ahmetcan-akuz/Optimus-Primary-Winding/Reports/Final Report/pictures/transformer_pri.JPG

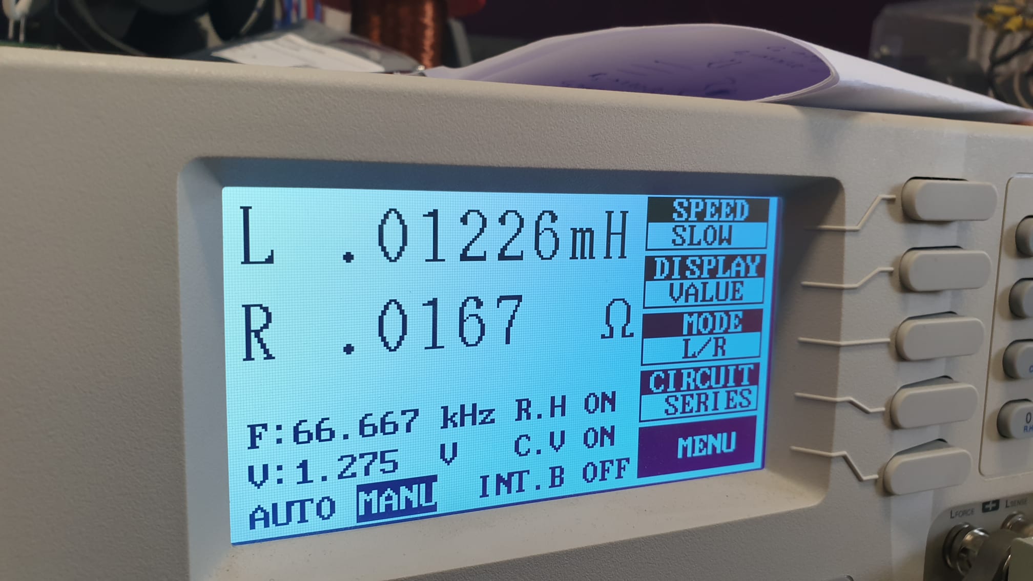
Reports/Final Report/pictures/transformer_pri.JPG
