ahmetcan-akuz/Optimus-Primary-Winding/Reports/Final Report/pictures/transformer_leak_init.jpg

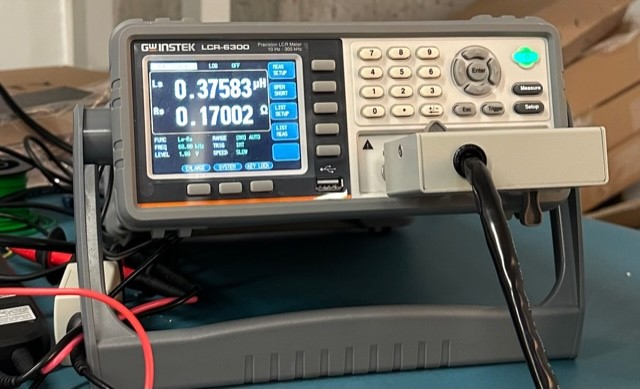
Reports/Final Report/pictures/transformer_leak_init.jpg
