ahmetcan-akuz/Optimus-Primary-Winding/README.md

# Optimus-Primary-Winding
This is the EE 464 Hardware Project Repository of Optimus Primary Winding
