ahmetcan-akuz/Optimus-Primary-Winding/PCB/Gerber2/Transcode Report.txt

   ---- Transcoding 'C:\Users\ahmetcan.akuz\Documents\GitHub\Optimus-Primary-Winding\PCB\Gerber2\flyback-B_Mask.gbr' ----   Sun Jun 11 21:21:48 2023

D12   --> D100
D13   --> D101
D14   --> D102
D15   --> D103
D16   --> D104
D17   --> D105
-----------------------------------------------------------------

   ---- Transcoding 'C:\Users\ahmetcan.akuz\Documents\GitHub\Optimus-Primary-Winding\PCB\Gerber2\flyback-Edge_Cuts.gbr' ----   Sun Jun 11 21:21:48 2023

D10   --> D106
-----------------------------------------------------------------

   ---- Transcoding 'C:\Users\ahmetcan.akuz\Documents\GitHub\Optimus-Primary-Winding\PCB\Gerber2\flyback-F_Cu.gbr' ----   Sun Jun 11 21:21:48 2023

D12   --> D107
D13   --> D108
D14   --> D109
D15   --> D110
D16   --> D111
D17   --> D112
D18   --> D113
-----------------------------------------------------------------

   ---- Transcoding 'C:\Users\ahmetcan.akuz\Documents\GitHub\Optimus-Primary-Winding\PCB\Gerber2\flyback-F_Mask.gbr' ----   Sun Jun 11 21:21:48 2023

D12   --> D114
D13   --> D115
D14   --> D116
D16   --> D117
D17   --> D118
D18   --> D119
D19   --> D120
D20   --> D121
D21   --> D122
D22   --> D123
D23   --> D124
D24   --> D125
D25   --> D126
D26   --> D127
D27   --> D128
D28   --> D129
D29   --> D130
D30   --> D131
D31   --> D132
D32   --> D133
D33   --> D134
D34   --> D135
D35   --> D136
D36   --> D137
-----------------------------------------------------------------

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
D31   --> D127
D32   --> D128
D33   --> D129
D34   --> D130
D35   --> D131
-----------------------------------------------------------------

   ---- Transcoding 'C:\Users\ahmetcan.akuz\Documents\GitHub\Optimus-Primary-Winding\PCB\Gerber2\flyback-F_Paste.gbr' ----   Sun Jun 11 22:03:01 2023

D10   --> D132
D11   --> D133
D12   --> D134
D13   --> D135
D14   --> D136
D15   --> D137
D16   --> D138
D17   --> D139
D19   --> D140
D20   --> D141
D21   --> D142
D22   --> D143
D23   --> D144
D24   --> D145
D25   --> D146
D26   --> D147
D27   --> D148
D28   --> D149
D29   --> D150
-----------------------------------------------------------------
