ahmetcan-akuz/Optimus-Primary-Winding/Presentation_Baris.pptx

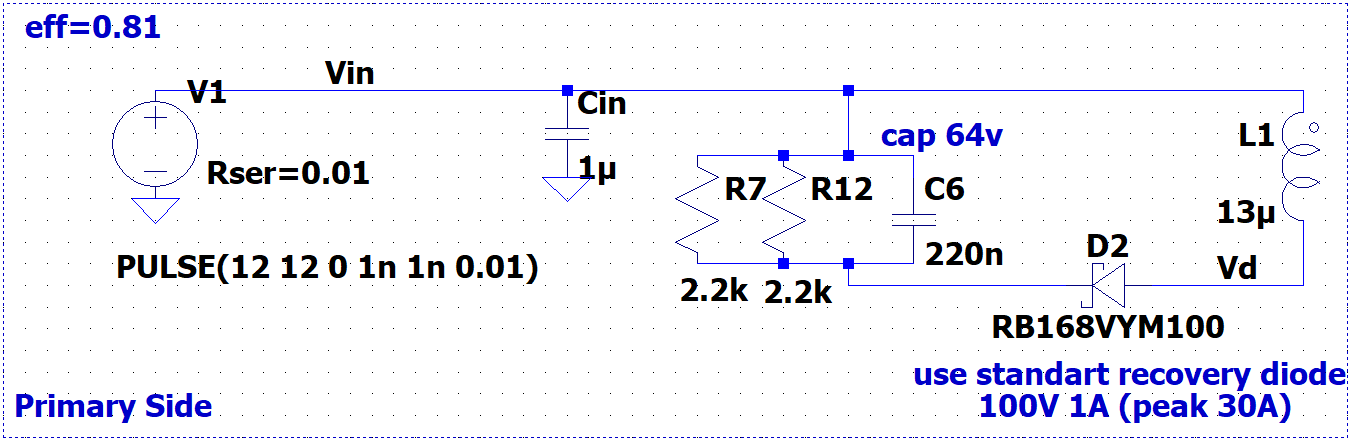
[picture p30: figure]

! 1W resistors will be used for snubbers

DIODE STAND. Single 1A 100V THT DO41

## Slide 2

Snubber Voltage and Primary Winding Current (12V input – Maximum Load)

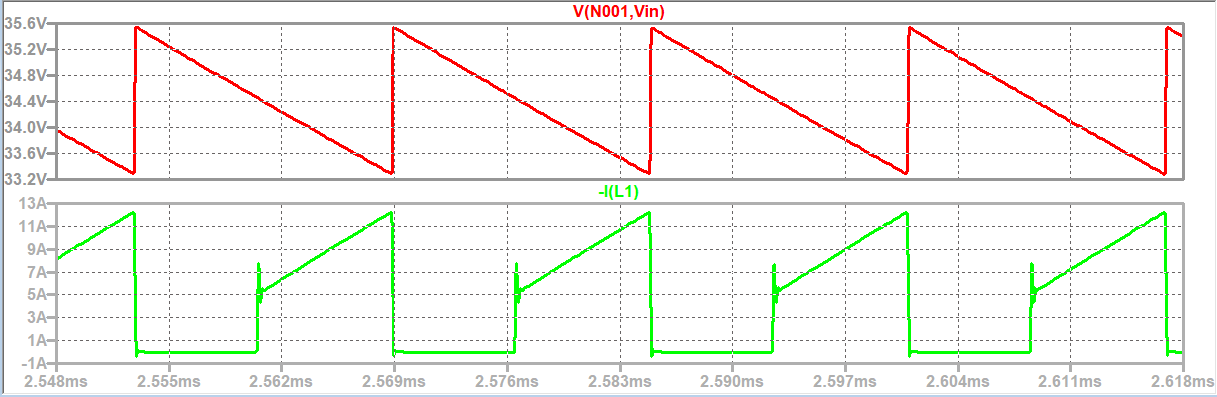
[picture p31: figure]

Snubber ripple is %10Vin and Vsnub=35V

## Slide 3

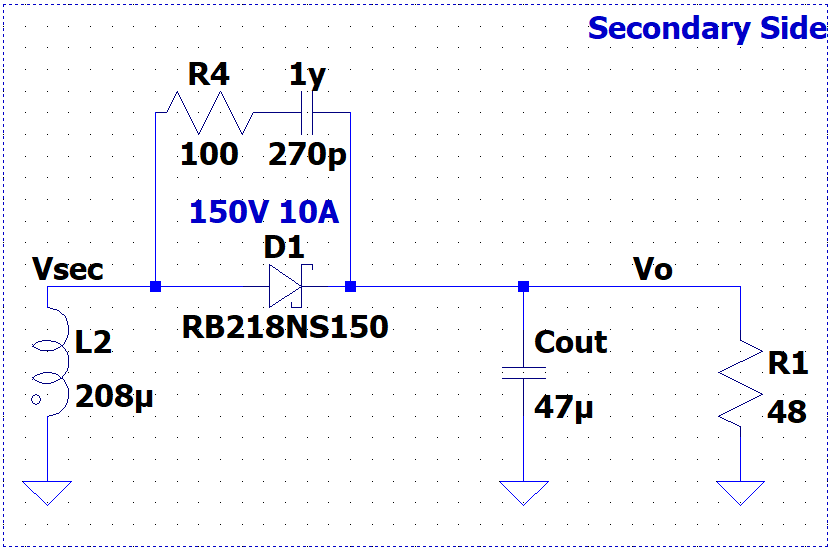
[picture p32: figure]

DIODE SCHOTTKY 10A 150V TO220AC THT

## Slide 4

Output Voltage,Secondary Diode Voltage and Winding Current (12V input – Maximum Load)

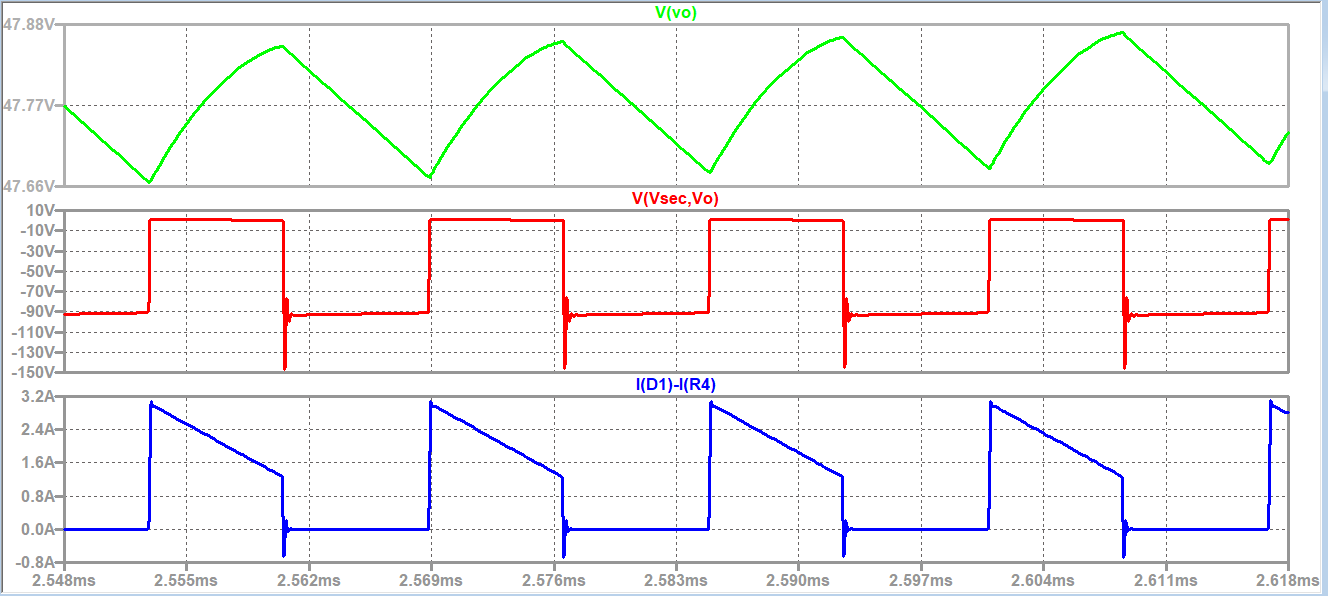
[picture p33: figure]

## Slide 5

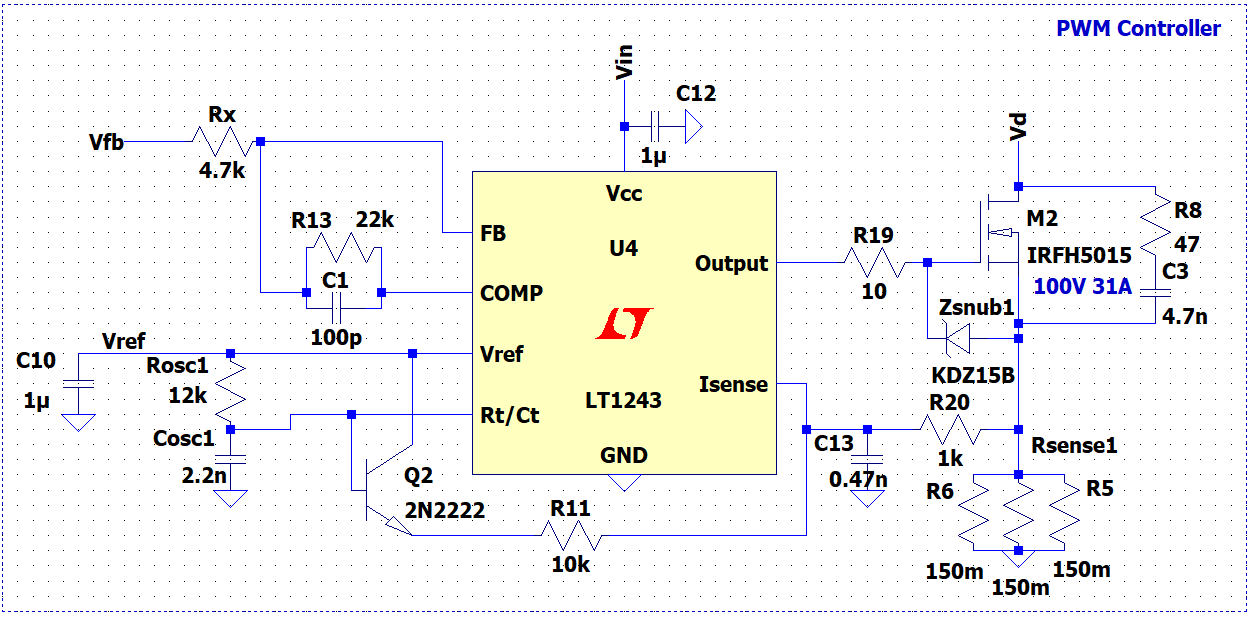
[picture p34: figure]

MOSFET DIS.31A 100V N-CH TO252(DPAK) HEXFET SMT

! 4W sense resistors will be used

## Slide 6

MOSFET Voltage and Current(12V input – Maximum Load)

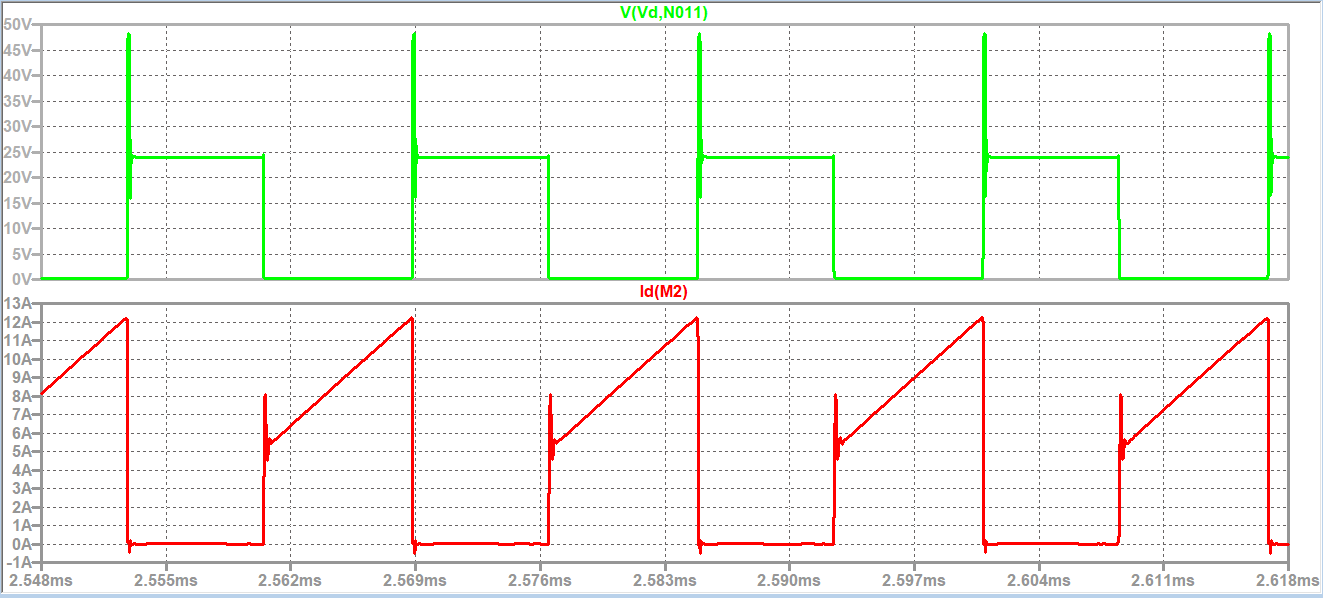
[picture p35: figure]

## Slide 7

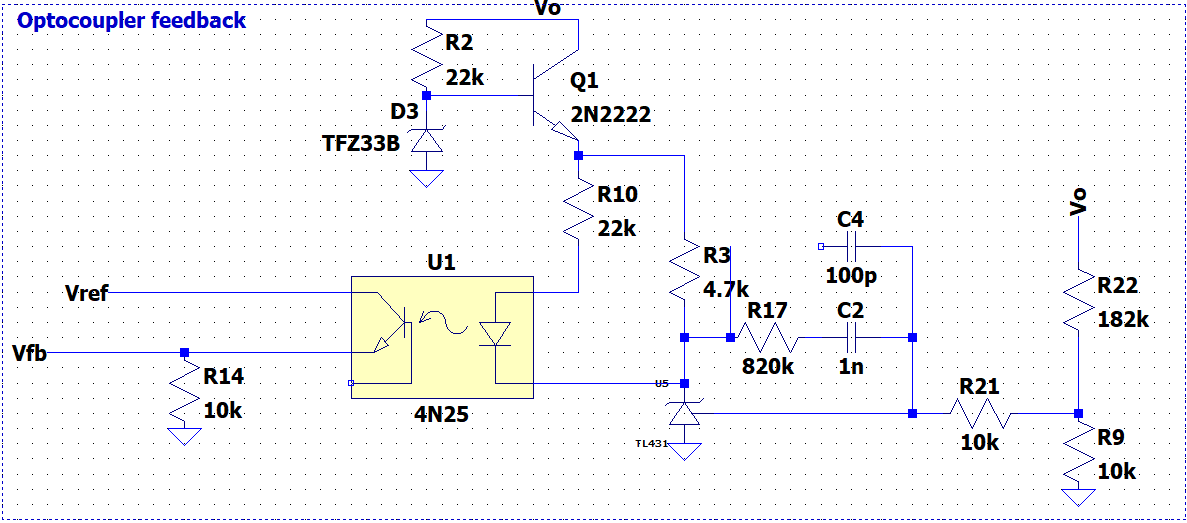
[picture p36: figure]

! Linear regulator will be used to protect TL431

## Thermal Calculations

MOSFET
P_(total) =P_(cond) +P_(sw) =R_(ds) ∙I_(avg)^2 +V_(DS(max)) ∙I_(on(avg)) ∙f_(sw) ∙(t_r +t_f )
P_(total) =0.039∙(5)^2 +24∙8∙60000∙(27+13)∙10^(−9) =1.44W
T_(junc) =T_(amb) +R_(JA(PCB)) ∙P_(total)
T_(junc) =25+40∙1.44=82.7 °C
! Maximum operating temperature is 175 °C

## Thermal Calculations

Secondary Diode
P_(total) =P_(cond) +P_(sw) =V_(on) ∙I_(out) +0 (Schottky)
P_(total) =0.9∙1=0.9W
T_(junc) =T_(amb) +R_(JA(PCB)) ∙P_(total)
T_(junc) =25+3∙0.9=27.7 °C
! Maximum operating temperature is 175 °C
