ahmetcan-akuz/Optimus-Primary-Winding/Design Excel/Flyback_Design.xlsx

Parameters
Vin_min | 12 | V
Vin_max | 18 | V
Vout | 48 | V
I_out | 1 | A
P_out | 48 | W
Dmax | 0.5
efficiency | 0.85
Pin | 56.47058824 | W
Np/Ns | 4
Lm | 13 | 1e-06 | 1.3e-05 | uH
f_sw | 60000 | Hz
I_pri | 8 | A
L_leak | 3.9e-07 | H
RCD Snubber Design
V_reflected | 12 | V
V_spike | 10 | V
R_clamp | 384.6153846 | Ohm
V_dc,expected | 40 | V
