ahmetcan-akuz/Optimus-Primary-Winding/Design Excel/Transformer_Design_Excel.xlsx

Sheet: Transformer_Design
Requirements
Voltage Pri Min | 12 | V
Voltage Pri Max | 18 | V
POWER Out | 48 | W
Efficiency | 0.85
Fsw | 60000 | Hz
Vout | 48 | V
Vout_diode | 1 | V
Reflected Voltage (Vr) | 12 | V |  |  | Note: | Vr is chosen as 12V to obtain Dmax=0.5
Krf | 0.4
Power Calculations
Pin_max | 56.47058824 | W
I_pri | 18.82352941 | A
Duty Cyle (Dmax) | 0.5 |  |  |  | 12 |  |  |  | 13 |  |  | 14 |  | 15
Ipri,rms | 7.684673703 | Arms
Transformer Characteristics and Calculations
Bmax | 0.27 | T |  |  | 21 |  |  |  | 22 |  |  |  | 23
Ae | 233 | mm^2
Window Area,Aw | 341 | mm^2
A_L | 5200 | nH/turns^2 | Selected Core Name: |  | E42/21/20-3C94
L_pri | 1.328125e-05 | H | 13.28125 | uH
Np | 3.973931013
Turn ratio (Np/Ns) | 0.2448979592
Np_integer | 4
Ns | 16.33333333
Ns_integer | 16
Isec | 4.705882353 | A
Isec,rms | 1.921168426 | A
Current Desity, J | 5 | A/mm^2
A_pri | 1.536934741 | mm^2
A_sec | 0.3842336851 | mm^2
primary cable AWG | 24 | Area | 0.205 | mm^2 | Diameter | 0.51054 | mm | Parallel | 8 | R_pri | 0.0841976 | Ohm/m
secondary cable AWG | 24 | Area | 0.205 | mm^2 | Diameter | 0.51054 | mm | Parallel | 2 | R_sec | 0.0841976 | Ohm/m
Winding Area | 13.12 | mm^2
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
