ahmetcan-akuz/Optimus-Primary-Winding/Magnetic Design/Source_Documents/FXCStainmetzCoefficients.xls

Sheet: Loss Coefficients
 |  |  |  |  |  |  |  |  |  | Freq |  |  | 200000 | Hz | (Sine signal)
 |  |  |  |  |  |  |  |  |  | B |  |  | 0.15 | T
 |  |  |  |  | (f in Hz, B in T, T in deg C) |  |  |  |  | T |  |  | 100 | C
(see not in the bottom)
Material | Status | Freq min | Freq max | Cm | x_1 | y_1 | Ct2_1 | Ct1_1 | Ct_1 | Freq chk |  |  | Pv (mw/cc) |  | Update | T [C] | 20 | 40 | 60 | 80 | 100 | 120 | B [T] | 0.005 | 0.01 | 0.02 | 0.05 | 0.1 | 0.15 | 0.2 | 0.25 | 0.3 | 0.35
3C90 | Standard | 20000 | 200001 | 3.2 | 1.46 | 2.75 | 0.000165 | 0.031 | 2.45 | 1 | 1 | 2 | 952.59 |  |  | 3C90 F=200 B=150 | 1806.105301 | 1404.11351 | 1127.863226 | 977.3544511 | 952.5871843 | 1053.561426 | 3C90 F=200 T=100C | 0.08256980975 | 0.5554612562 | 3.736683033 | 46.43241623 | 312.3588189 | 952.5871843
3C91 | Standard | 10000 | 100000 | 3.5 | 1.4 | 2.5 | 0.000142 | 0.013 | 0.88 | 1 | 0 | 1
3C91 |  | 100000 | 200000 | 3.5 | 1.4 | 2.5 | 0.000142 | 0.013 | 0.88 | 1 | 0 | 1
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
