ahmetcan-akuz/Optimus-Primary-Winding/Reports/Final Report/pictures/pcb.jpg

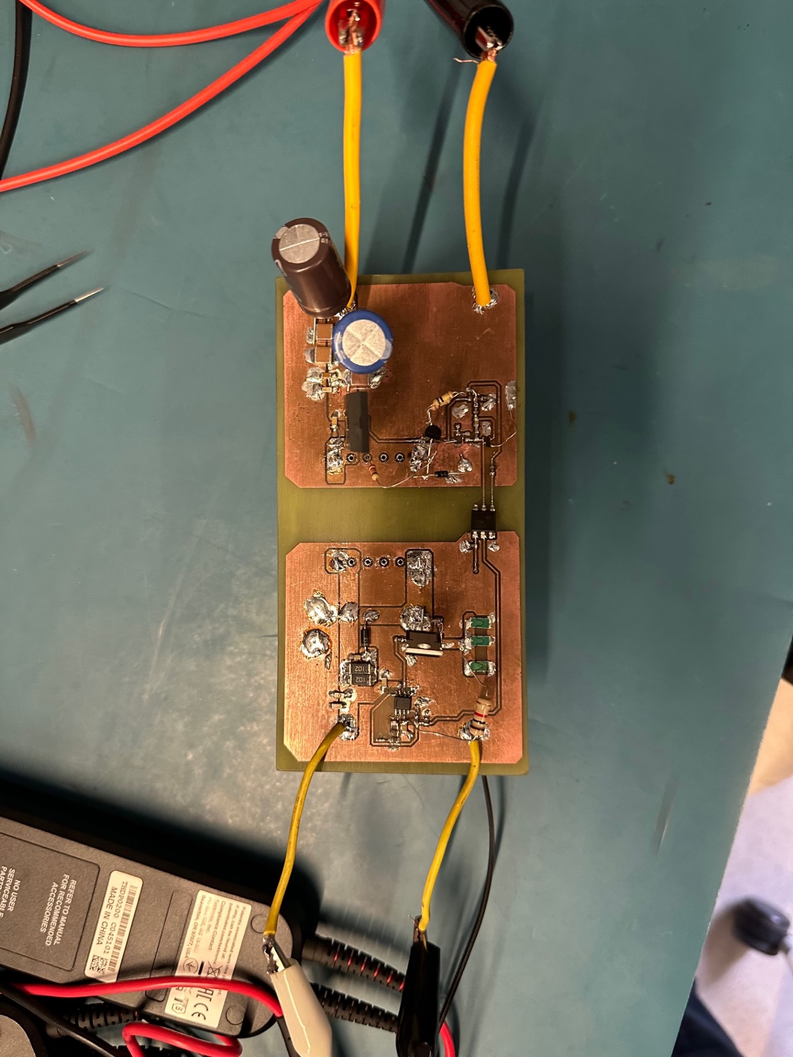
Reports/Final Report/pictures/pcb.jpg
