ahmetcan-akuz/Optimus-Primary-Winding/Simulations/sim.png

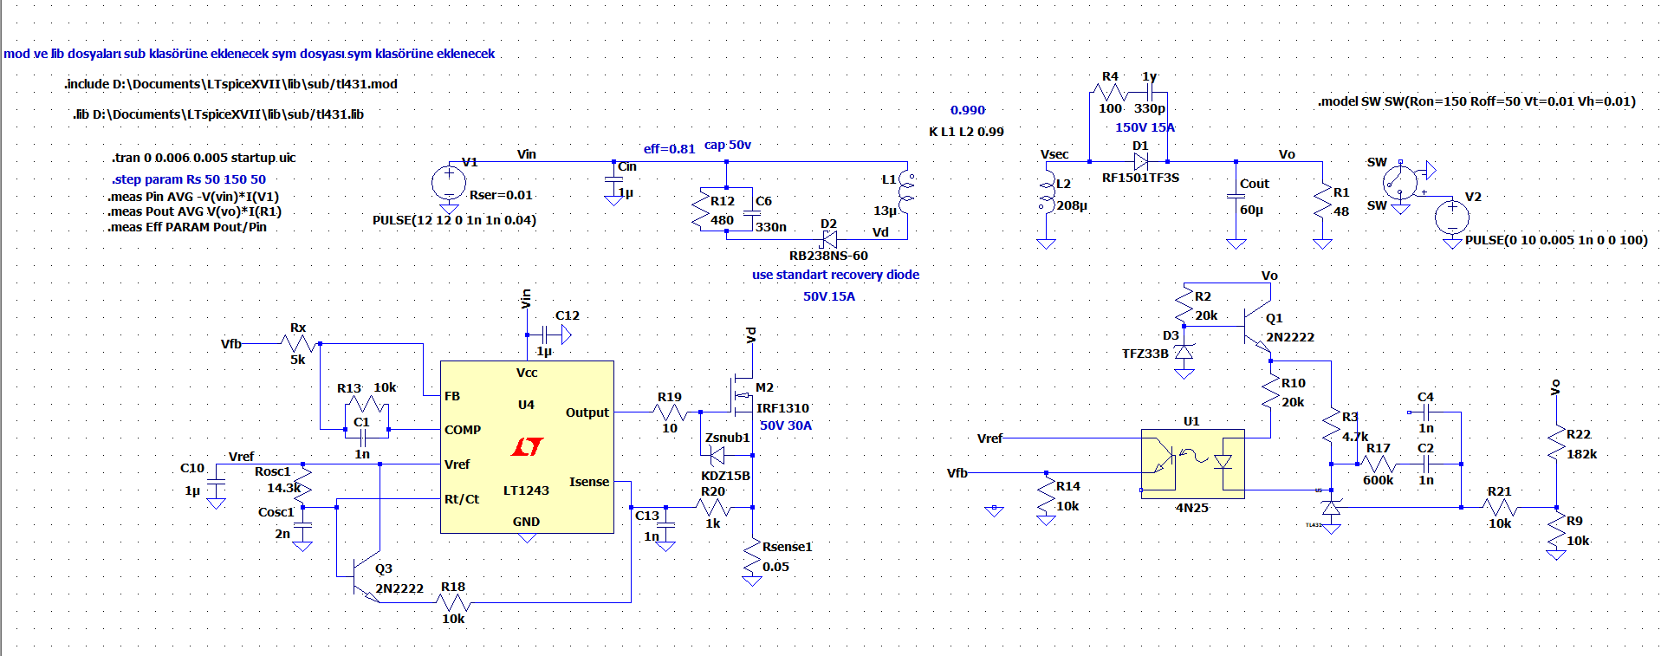
Simulations/sim.png
