ahmetcan-akuz/Optimus-Primary-Winding/Component_List.xlsx

Component | Price | Link | Qty. | Description | Column1
E42/21/20-3C94 | $2.64 | https://www.digikey.com/en/products/detail/ferroxcube/E42-21-20-3C94/7041500 | 1 | FERRITE CORE
Caps -1u 25V x1 -220n 63V x1 -1uF x2 -100pF x1 -4.7nF 63V x1 -470pF x1 -2.2nF x1 -1nF x1 -270pF 1000V x1 (150V yok mecbur 1000) -47uF 100V x1 |  | 1) 270pyerine 470pF 500v cap: https://ozdisan.com/pasif-komponentler/kondansatorler/smt-smd-ve-mlcc-kondansatorler/CL31B471KGFNNNE/484778
Resistor -2.2k 1W x2 -100R 1W x1 -47R 1W x1 -150m (4W) x3 (aşağıda yazdım) -10R x1 -1k x1 -22k x3 -4.7k x2 -10k x3 -100k x1 + 82k x1 (%1 olursa iyi olur) -820k x1
TL431 | 0,18929 USD | https://ozdisan.com/entegre-devreler-ics/guc-entegreleri/voltage-reference-entegreleri/TL431AIDBZR/341981 | 1 | Precision Programmable Reference |  | KiCAD Available
IC-3843 REG. CONTROLLER PWM CM SOIC8 | 1,06870 USD | https://ozdisan.com/entegre-devreler-ics/guc-entegreleri/dc-dc-voltaj-kontrolorleri/UC3843AD8TR/461759 | 1 | PWM Controller | UC3843AD8TR | KiCAD Available
DIODE ZENER 500mW 30V ±5% SOD123 SMT | 0,05405 USD | https://ozdisan.com/guc-yari-iletkenleri/diyotlar-modul-diyotlar-ve-dogrultucular/zener-diyotlar/MMSZ4713-VR100001/563477 | 1 | 30V Zener (For Linear Regulator) | MMSZ4713 | MMSD4148
DIODE ZENER 300mW 15V SOD323 | 0,03367 USD | https://ozdisan.com/guc-yari-iletkenleri/diyotlar-modul-diyotlar-ve-dogrultucular/zener-diyotlar/MM3Z15VT1G/625608 | 1 | 15V Zener (Voltage depends on Vds) |  | MM3Zxx
2N2222 Transistör BJT TO-92 - NPN 6V 0.8A | 0,99 TL | https://www.direnc.net/2n2222-transistor-bjt-npn-to-92 | 2 | 2n2222 BJT |  | KiCAD Available
IC-4N25 OPTO 5300V TRANS.OUTPUT SMD6 LITEON | 0,17620 USD | https://ozdisan.com/optolar-ve-sensorler/optolar/transistor-cikisli-optokuplorler/4N25S-TA1/434368 | 1 | 4N25 Optocoupler |  | KiCAD Available
25A 5x20mm Cam Sigorta | 0,54 TL | https://www.direnc.net/25a-ufak-cam-sigorta-20mm | 1 | 25A Fuse
RES.SHUNT (6432) 2512 150m Ohms 1% 4W AUTO SMT | 0,80546 USD | https://ozdisan.com/pasif-komponentler/direncler/hassas-ve-sont-direncler/VMS-R150-1-0-U/536802 | 3 | 150m Sense Resistor 4W |  | KiCAD Available
MOSFET DIS.31A 100V N-CH TO252(DPAK) HEXFET SMT | 0,60306 USD | https://ozdisan.com/guc-yari-iletkenleri/mosfetler/discrete-mosfetler/IRFR3410TRLPBF/443366 | 1 | 100V 31A MOSFET
DIODE SCHOTTKY 10A 150V TO220AC THT | 0,47311 USD | https://ozdisan.com/guc-yari-iletkenleri/diyotlar-modul-diyotlar-ve-dogrultucular/schottky-diyotlar/MBR10150T000001/573568 | 1 | 150V 10A Schottky Diode | MBR10150_T0_00001 | MBR735
DIODE STAND. Single 1A 100V THT DO41 | 0,02037 USD | https://ozdisan.com/guc-yari-iletkenleri/diyotlar-modul-diyotlar-ve-dogrultucular/genel-amacli-diyotlar/1N4002/735859 | 1 | 100V 1A Diode | 1N4002 | KiCAD Available
Pasif |  | Link | Adet
4.7uF, 100V | Capacitor | https://ozdisan.com/pasif-komponentler/kondansatorler/smt-smd-ve-mlcc-kondansatorler/C5750X7R2A475K230KA/473761 | 1
470pF 500v | Capacitor | https://ozdisan.com/pasif-komponentler/kondansatorler/smt-smd-ve-mlcc-kondansatorler/CL31B471KGFNNNE/484778 | 1
10uF, 100V | Capacitor | https://ozdisan.com/pasif-komponentler/kondansatorler/smt-smd-ve-mlcc-kondansatorler/C5750X7S2A106M230KB/468524 | 4
100nF, 100V | Capacitor | https://ozdisan.com/pasif-komponentler/kondansatorler/smt-smd-ve-mlcc-kondansatorler/AC0805KKX7R0BB104/750474 | 2
10nF,100V | Capacitor | https://ozdisan.com/pasif-komponentler/kondansatorler/smt-smd-ve-mlcc-kondansatorler/CC1206KRX7R0BB103/750614 | 2
1uF, 100V | Capacitor | https://ozdisan.com/pasif-komponentler/kondansatorler/smt-smd-ve-mlcc-kondansatorler/CL21Y105KCFVPJE/634349 | 2
2.2nF, 50V | Capacitor | https://ozdisan.com/pasif-komponentler/kondansatorler/smt-smd-ve-mlcc-kondansatorler/CL21B222KBANNNC/16612 | 1
470p/0.47nF, 50V | Capacitor | https://ozdisan.com/pasif-komponentler/kondansatorler/smt-smd-ve-mlcc-kondansatorler/CL21B471KBANNNC/10430 | 1
4.7nF, 50V | Capacitor | https://ozdisan.com/pasif-komponentler/kondansatorler/smt-smd-ve-mlcc-kondansatorler/CL21B472KBANNNC/11154 | 1
100pF, 50V | Capacitor | https://ozdisan.com/pasif-komponentler/kondansatorler/smt-smd-ve-mlcc-kondansatorler/CC0805JRNPO9BN101/576598 | 1
220nF,100V | Capacitor | https://ozdisan.com/pasif-komponentler/kondansatorler/smt-smd-ve-mlcc-kondansatorler/CC0805KKX7R0BB224/617904 | 1
1nF, 100V | Capacitor | https://ozdisan.com/pasif-komponentler/kondansatorler/smt-smd-ve-mlcc-kondansatorler/CL21B102KC6WPNC/522755 | 1
