ahmetcan-akuz/Optimus-Primary-Winding/(list of files, drawings)

Other design files:
PCB/flyback/Imported (1) flyback/flyback.PcbDoc
PCB/flyback/Imported (1) flyback/flyback.PrjPcb
PCB/flyback/Imported (1) flyback/flyback.SchDoc
PCB/flyback/Imported (1) flyback/flyback.SchLib
PCB/flyback/Imported flyback/flyback(1).PcbDoc
PCB/flyback/Imported flyback/flyback.PcbDoc
PCB/flyback/Imported flyback/flyback.PrjPcb
PCB/flyback/Imported flyback/flyback.SchDoc
PCB/flyback/Imported flyback/flyback.SchLib
