ahmetcan-akuz/Optimus-Primary-Winding/PCB/flyback/flyback.kicad_sch

## KiCad design PCB/flyback/flyback.kicad_sch (2023-06-24)

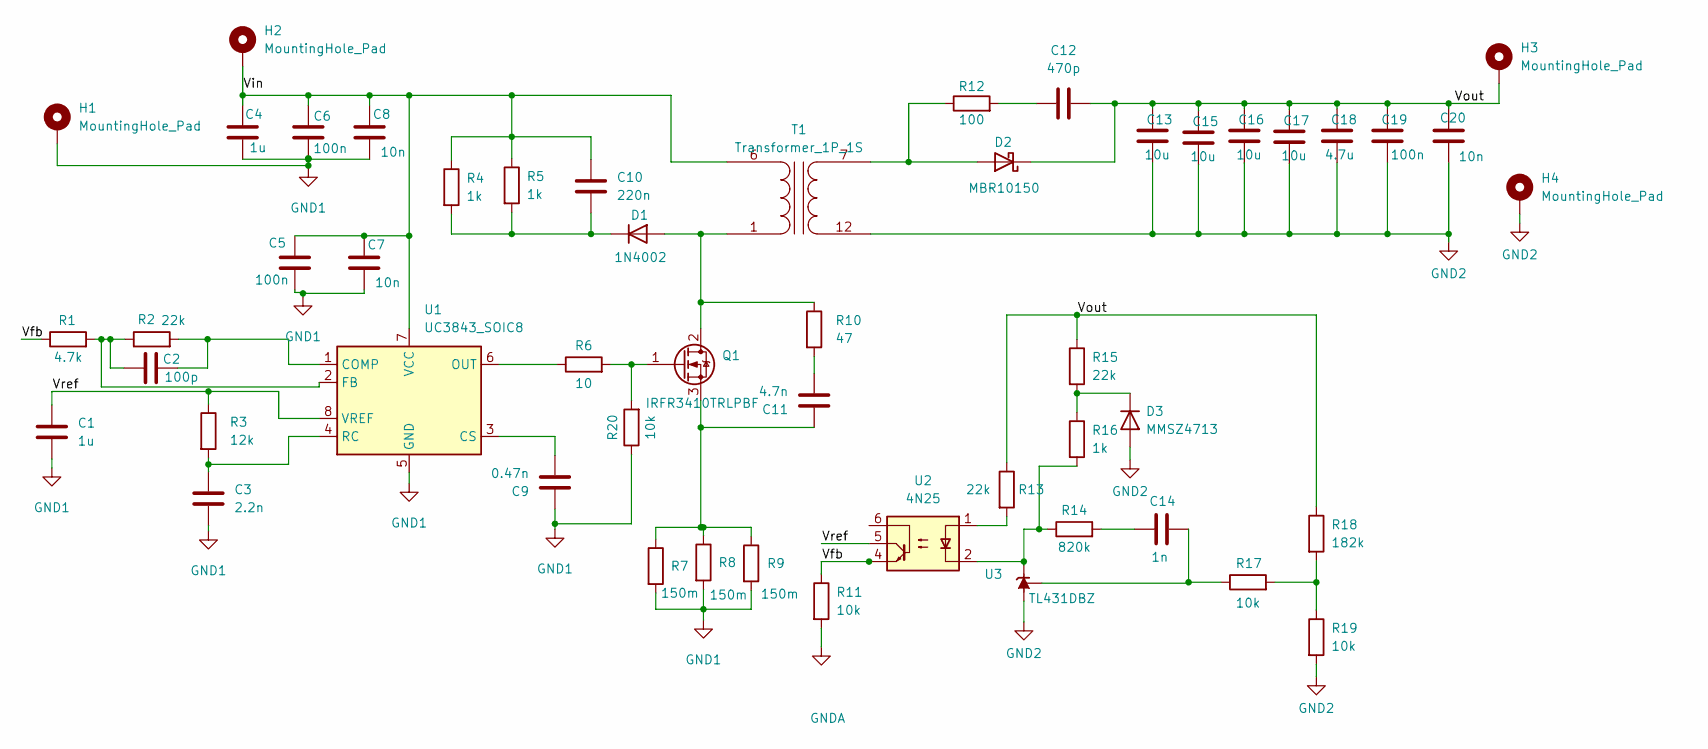
[picture p42: schematic flyback.kicad_sch]

Parts:
C1, C4: 1u; C_0805_2012Metric
C2: 100p; C_0805_2012Metric
C3: 2.2n; C_0805_2012Metric
C5, C6, C19: 100n; C_0805_2012Metric
C7, C8, C20: 10n; C_1206_3216Metric
C9: 0.47n; C_0805_2012Metric
C10: 220n; C_0805_2012Metric
C11: 4.7n; C_0805_2012Metric
C12: 470p; C_1206_3216Metric
C13, C15, C16, C17: 10u; C_2220_5650Metric
C14: 1n; C_0805_2012Metric
C18: 4.7u; C_2220_5650Metric
D1: 1N4002; D_DO-41_SOD81_P10.16mm_Horizontal
D2: MBR10150; TO-220-2_Vertical
D3: MMSZ4713; D_SOD-123
H1, H2, H3, H4: MountingHole_Pad; MountingHole_2.2mm_M2
Q1: IRFR3410TRLPBF; TO-252-2
R1: 4.7k; R_0805_2012Metric
R2, R13, R15: 22k; R_0805_2012Metric
R3: 12k; R_0805_2012Metric
R4, R5, R16: 1k; R_0805_2012Metric
R6: 10; R_0805_2012Metric
R7, R8, R9: 150m; R_2512_6332Metric
R10: 47; R_0805_2012Metric
R11, R17, R19, R20: 10k; R_0805_2012Metric
R12: 100; R_0805_2012Metric
R14: 820k; R_0805_2012Metric
R18: 182k; R_0805_2012Metric
T1: Transformer_1P_1S; Transformer_37x44
U1: UC3843_SOIC8; SOIC-8_3.9x4.9mm_P1.27mm
U2: 4N25; DIP-6_W7.62mm_SMDSocket_SmallPads
U3: TL431DBZ; SOT-23

Connections:
GND1: C1.2, C3.2, C4.1, C5.1, C6.1, C7.1, C8.1, C9.1, H1.1, R7.2, R8.2, R9.2, R20.1, U1.5 (GND)
GND2: C13.1, C15.1, C16.1, C17.1, C18.1, C19.1, C20.1, D3.2 (A), H4.1, R19.2, T1.12 (SA), U3.3 (A)
GNDA: R11.2
unnamed: C2.1, R1.2, R2.1, U1.2 (FB)
unnamed: C2.2, R2.2, U1.1 (COMP)
unnamed: C3.1, R3.2, U1.4 (RC)
unnamed: C9.2, U1.3 (CS)
unnamed: C10.2, D1.1 (K), R4.2, R5.2
unnamed: C11.1, Q1.3 (S), R7.1, R8.1, R9.1
unnamed: C11.2, R10.2
unnamed: C12.1, R12.2
unnamed: C14.1, R14.2
unnamed: C14.2, R17.1, U3.2 (REF)
unnamed: D1.2 (A), Q1.2 (D), R10.1, T1.1 (AB)
unnamed: D2.2 (A), R12.1, T1.7 (SB)
unnamed: D3.1 (K), R15.2, R16.1
unnamed: Q1.1 (G), R6.2, R20.2
unnamed: R6.1, U1.6 (OUT)
unnamed: R13.2, U2.1
unnamed: R14.1, R16.2, U2.2, U3.1 (K)
unnamed: R17.2, R18.2, R19.1
Vfb: R1.1, R11.1, U2.4
Vin: C4.2, C5.2, C6.2, C7.2, C8.2, C10.1, H2.1, R4.1, R5.1, T1.6 (AA), U1.7 (VCC)
Vout: C12.2, C13.2, C15.2, C16.2, C17.2, C18.2, C19.2, C20.2, D2.1 (K), H3.1, R13.1, R15.1, R18.1
Vref: C1.1, R3.1, U1.8 (VREF), U2.5
