ahmetcan-akuz/Optimus-Primary-Winding/(commit log)

2023-04-27 Transformer Design Calculator Excel was added.
    [Transformer_Design_Excel.xlsx]
2023-04-28 Magnetic Design Excel Updated Source Documents Added
    [Transformer_Design_Excel.xlsx]
2023-04-28 Magnetic Design Updated
    [Transformer_Design_Excel.xlsx]
2023-04-28 Magnetic Design Update
    Design was updated as 8uH/0.6 duty cycle version.
    [Transformer_Design_Excel.xlsx]
2023-05-02 Magnetic Design Updated wrt CCM Mode
    [Transformer_Design_Excel.xlsx]
2023-05-02 Magnetic Desing Update
    Excel was updated. Datasheet of core was added.
    [Transformer_Design_Excel.xlsx]
2023-05-02 Cable Selection Part was added.
    [Transformer_Design_Excel.xlsx]
2023-05-03 Magnetic Design Updated
    Datasheet of core also added to repo.
    [Transformer_Design_Excel.xlsx]
2023-05-03 Cable resistances were added
    [Transformer_Design_Excel.xlsx]
2023-05-03 Updated the simulation file with the non-idealities
    Component list file added
    Simulation file added with magnetic design and non-idealities
    [Component_List.xlsx]
2023-05-04 Component List Update
    [Component_List.xlsx]
2023-05-04 update on components and sim file
    [Component_List.xlsx]
2023-05-04 Magnetic Design Parameters were finalized
    [Transformer_Design_Excel.xlsx]
2023-05-05 Magnetic Design Report Update
    [Transformer_Design_Excel.xlsx]
2023-05-05 Simulations and Design Decisions
    [Component_List.xlsx]
2023-05-05 Magnetic Design Report Updated
    [FXCStainmetzCoefficients.xls, Transformer_Design_Excel.xlsx]
2023-05-06 update on components and simulation
    [Component_List.xlsx]
2023-05-06 Updates on component list simulation
    [Component_List.xlsx]
2023-05-09 Presentation for simulations and thermal design
    [Component_List.xlsx]
2023-05-10 Presentation added, Excel Updated
    [Transformer_Design_Excel.xlsx]
2023-05-10 Temp Rise Calculation Added
    [Transformer_Design_Excel.xlsx]
2023-05-16 Simplified Design Update
    Additional RC circuit eliminated. Snubber design updated.
2023-05-17 Flyback Design Excel Added
    [Flyback_Design.xlsx, Transformer_Design_Excel.xlsx]
2023-05-17 update on schematics
2023-05-17 update on components
    [Component_List.xlsx]
2023-05-17 PCB Design Added
    [Component_List.xlsx, flyback.kicad_pcb, flyback.kicad_sch]
2023-05-18 Schematic Update
    [Component_List.xlsx, flyback.kicad_sch]
2023-05-22 Flyback Update
    [flyback.kicad_sch]
2023-05-22 Schematic Finalize
    [Component_List.xlsx, flyback.kicad_sch]
2023-05-23 PCB Update
    [flyback.kicad_pcb, flyback.kicad_sch]
2023-05-23 Layout Update
    [flyback.kicad_pcb, flyback.kicad_sch]
2023-05-29 Gerber Files Added
    [flyback-B_Cu.gbr, flyback-B_Mask.gbr, flyback-B_Paste.gbr, flyback-Edge_Cuts.gbr, flyback-F_Cu.gbr, flyback-F_Mask.gbr, flyback-F_Paste.gbr, flyback-NPTH.drl]
2023-05-29 Transformer Footprint Updated
    [flyback.kicad_pcb, flyback.kicad_sch]
2023-06-01 imported kicad files to altium-baris
    [flyback(1).PcbDoc, flyback.PcbDoc, flyback.PrjPcb, flyback.SchDoc, flyback.SchLib]
2023-06-16 Non ideal diodes added to simulation
2023-06-24 Magnetic Design Added
